pinnet/EasyPicoVGA/pico_vga_sd_aud_BOM_r2.xlsx

RPI-PVAS pico_vga_sd_aud BOM Rev2
17/079/2020
Reference designators | Quantity | Manufacturer Part Number (MPN) | Manufacturer | Description | Value
C1, C2 | 2 | GCM188R71C105KA64J | Murata | CAP CER 1UF 16V X7R 0603 | 1u
C9, C11 | 2 | GRM188R71A225KE15D | Murata | CAP CER 2.2UF 10V X7R 0603 | 2.2u
C3, C10, C16, C19 | 4 | GRM188R61A106KE69J | Murata | CAP CER 10UF 10V X5R 0603 | 10u
C4, C5, C6, C7, C8, C12, C13 | 7 | GRM155R71E104KE14J | Murata | CAP CER 0.1UF 25V X7R 0402 | 100n
C14, C15, C21 | 3 | GRM219R60J476ME44D | Murata | CAP CER 47UF 6.3V X5R 0805 | 47u
C17, C18 | 2 | GRM155R71H222KA01D | Murata | CAP CER 2200PF 50V X7R 0402 | 2.2n
D1 | 1 | MBR120VLSFT1G | ON Semiconductor | DIODE SCHOTTKY 20V 1A SOD123FL | MBR120VLSFT1G
J1, J2 | 2 | SJ-3523-SMT-TR | CUI Devices | CONN JACK STEREO 3.5MM SMD R/A | SJ-3523-SMT
J3 | 1 | 104031-0811 | Molex | CONN MICRO SD CARD PUSH-PULL R/A | 104031-0811
J4 | 1 | L77HDE15SD1CH4F | Amphenol ICC (Commercial Products) | CONN DSUB HD RCPT 15POS R/A SLDR | L77HDE15SD1CH4F
J5 | 1 | 10103594-0001LF | Amphenol ICC (FCI) | CONN RCPT USB2.0 MICRO B SMD R/A | 10103594-0001LF
J6 | 1 | TSW-102-23-T-S | Samtec Inc. | CONN HEADER VERT 2POS 2.54MM | TSW-102-23-T-S
J7 | 1 | 67997-208HLF | Amphenol ICC (FCI) | CONN HEADER VERT 8POS 2.54MM | 67997-208HLF
R1, R2 | 2 | RC0402FR-07220RL | Yageo | RES SMD 220 OHM 1% 1/16W 0402 | 220
R3, R4 | 2 | RC0402FR-07100RL | Yageo | RES SMD 100 OHM 1% 1/16W 0402 | 100
R5, R6 | 2 | RC0402FR-07470RP | Yageo | RES SMD 470 OHM 1% 1/16W 0402 | 470
R7, R8 | 2 | RC0402FR-071K8L | Yageo | RES SMD 1.8K OHM 1% 1/16W 0402 | 1.8K
R10, R11 | 2 | RC0402FR-0747RL | Yageo | RES SMD 47 OHM 1% 1/16W 0402 | 47
R20, R21, R22, R27, R32, R37 | 6 | RC0402FR-071KP | Yageo | RES SMD 1K OHM 1% 1/16W 0402 | 1k
R23, R24 | 2 | RC0402FR-0710KP | Yageo | RES SMD 10K OHM 1% 1/16W 0402 | 10k
R26, R31, R36 | 3 | RC0402FR-07499RL | Yageo | RES SMD 499 OHM 1% 1/16W 0402 | 499
R28, R33, R38 | 3 | RC0402FR-072KL | Yageo | RES SMD 2K OHM 1% 1/16W 0402 | 2k
R29, R34, R39 | 3 | RC0402FR-074K02L | Yageo | RES SMD 4.02K OHM 1% 1/16W 0402 | 4.02k
R30, R35, R40 | 3 | RC0402FR-078K06L | Yageo | RES SMD 8.06K OHM 1% 1/16W 0402 | 8.06k
SW1, SW2, SW3, SW4 | 4 | 434133025816 | Würth Elektronik | TACT SWITCH 4.2X3.2MM VERTICAL T | 434133025816
U1 | 1 | TLV70033DDCR | Texas Instruments | IC REG LINEAR 3.3V 200MA SOT23-5 | TLV70033DDCR
U3 | 1 | NC7WZ16P6X | ON Semiconductor | IC BUF NON-INVERT 5.5V SC70-6 | NC7WZ16P6X
U4 | 1 | PCM5101APWR | Texas Instruments | IC DAC 16/24/32BIT 384K 20TSSOP | PCM5101APWR
