pinnet/EasyPicoVGA/pico_vga_sd_aud.kicad_pcb

## KiCad design pico_vga_sd_aud.kicad_pcb (2021-02-02)

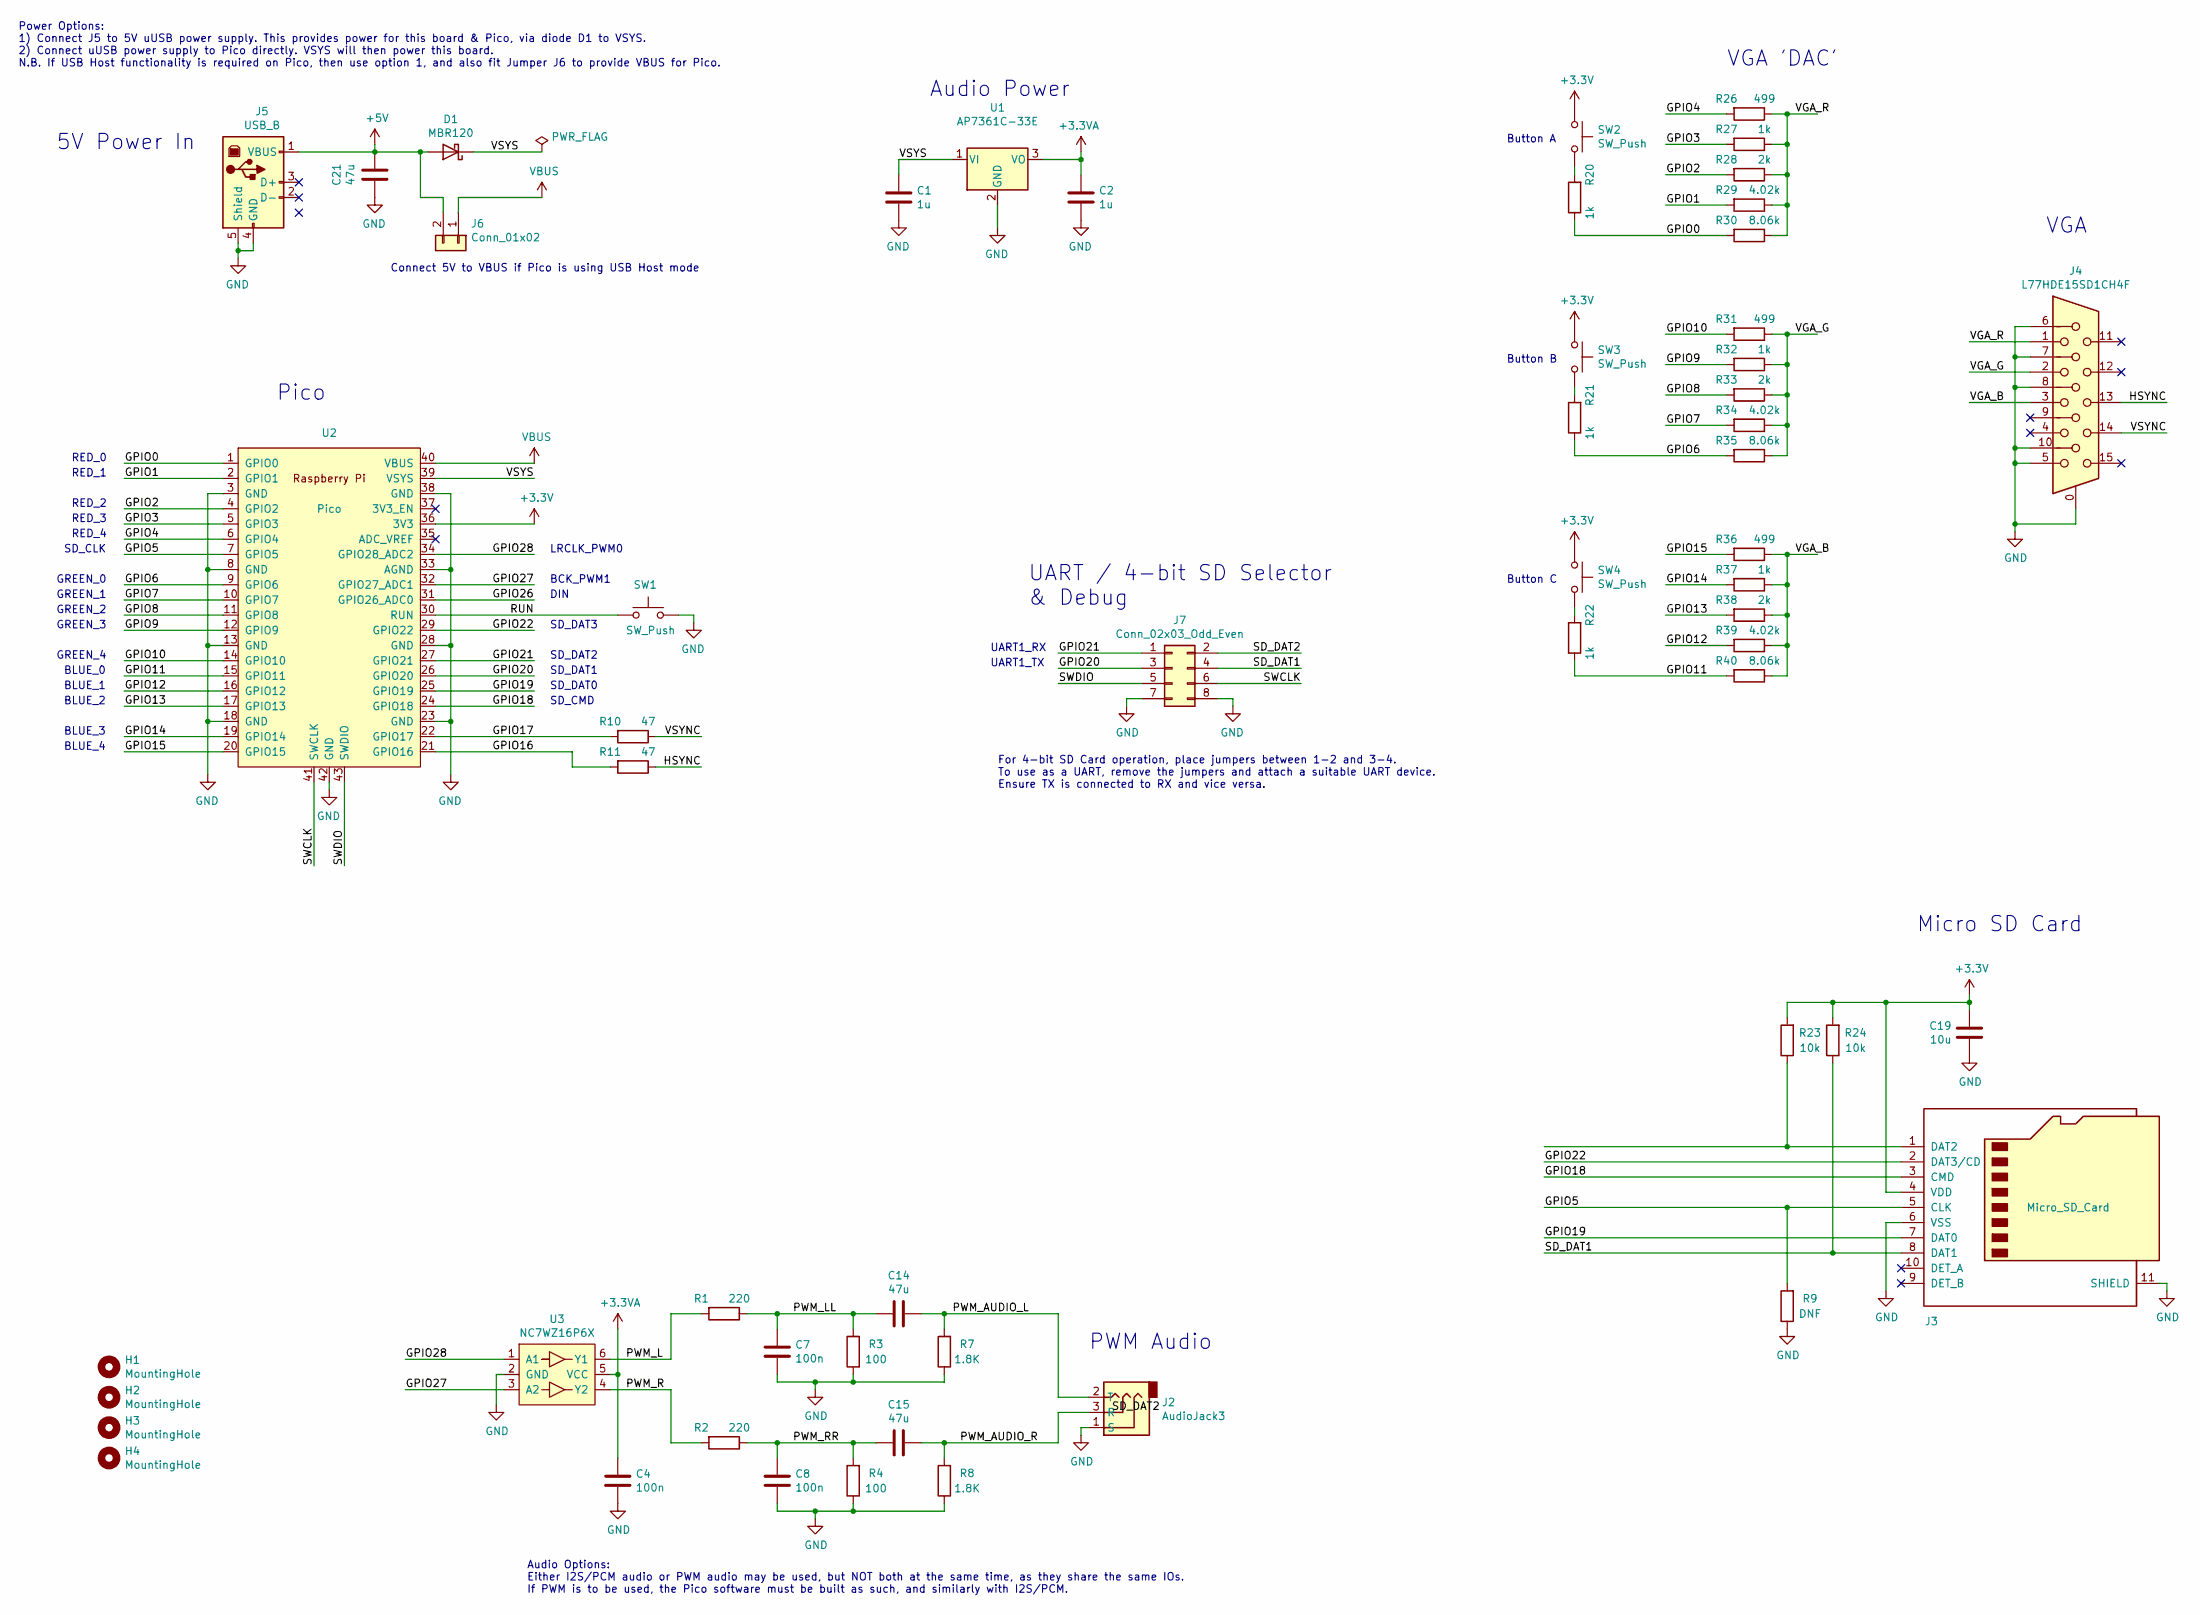
[picture p1: schematic pico_vga_sd_aud.sch, RPI-PVSA VGA, SD Card & Audio Demo Board for Pico]

Parts:
C1, C2: 1u; C_Disc_D4.7mm_W2.5mm_P5.00mm
C4, C7, C8: 100n; C_Disc_D4.7mm_W2.5mm_P5.00mm
C14, C15, C21: 47u; CP_Radial_D5.0mm_P2.50mm
C19: 10u; CP_Radial_D6.3mm_P2.50mm
D1: MBR120; D_A-405_P12.70mm_Horizontal
H1, H2, H3, H4: MountingHole; MountingHole_2.7mm_M2.5
J2: AudioJack3; CUI_SJ-3523-audio-jack
J3: Micro_SD_Card; microSD_HC_Molex_104031-0811
J4: L77HDE15SD1CH4F; DSUB-15-L77HDE15SD1CH4F
J5: USB_B; USB_B_Lumberg_2411_02_Horizontal
J6: Conn_01x02; PinHeader_1x02_P2.54mm_Vertical
J7: Conn_02x03_Odd_Even; PinHeader_2x04_P2.54mm_Vertical
R1, R2: 220; R_Axial_DIN0207_L6.3mm_D2.5mm_P15.24mm_Horizontal
R3, R4: 100; R_Axial_DIN0207_L6.3mm_D2.5mm_P15.24mm_Horizontal
R7, R8: 1.8K; R_Axial_DIN0207_L6.3mm_D2.5mm_P15.24mm_Horizontal
R9: DNF; R_Axial_DIN0207_L6.3mm_D2.5mm_P15.24mm_Horizontal
R10, R11: 47; R_Axial_DIN0207_L6.3mm_D2.5mm_P15.24mm_Horizontal
R20, R21, R22, R27, R32, R37: 1k; R_Axial_DIN0207_L6.3mm_D2.5mm_P15.24mm_Horizontal
R23, R24: 10k; R_Axial_DIN0207_L6.3mm_D2.5mm_P15.24mm_Horizontal
R26, R31, R36: 499; R_Axial_DIN0207_L6.3mm_D2.5mm_P15.24mm_Horizontal
R28, R33, R38: 2k; R_Axial_DIN0207_L6.3mm_D2.5mm_P15.24mm_Horizontal
R29, R34, R39: 4.02k; R_Axial_DIN0207_L6.3mm_D2.5mm_P15.24mm_Horizontal
R30, R35, R40: 8.06k; R_Axial_DIN0207_L6.3mm_D2.5mm_P15.24mm_Horizontal
SW1, SW2, SW3, SW4: SW_Push; SW_Tactile_SPST_Angled_PTS645Vx83-2LFS
U1: AP7361C-33E; TO-92_Inline
U2: Pico; RPi_Pico_SMD_TH
U3: NC7WZ16P6X; SOT-363_SC-70-6

Connections:
+3.3VA: C2.1, C4.1, U1.3 (VO), U3.5 (VCC)
+3V3: C19.1, J3.4 (VDD), R23.2, R24.2, SW2.1, SW3.1, SW4.1, U2.36 (3V3)
+5V: C21.1, D1.2 (A), J5.1 (VBUS), J6.2
/GPIO0: R20.1, R30.2, U2.1 (GPIO0)
/GPIO1: R29.2, U2.2 (GPIO1)
/GPIO2: R28.2, U2.4 (GPIO2)
/GPIO3: R27.2, U2.5 (GPIO3)
/GPIO4: R26.2, U2.6 (GPIO4)
/GPIO5: J3.5 (CLK), R9.2, U2.7 (GPIO5)
/GPIO6: R21.1, R35.2, U2.9 (GPIO6)
/GPIO7: R34.2, U2.10 (GPIO7)
/GPIO8: R33.2, U2.11 (GPIO8)
/GPIO9: R32.2, U2.12 (GPIO9)
/GPIO10: R31.2, U2.14 (GPIO10)
/GPIO11: R22.1, R40.2, U2.15 (GPIO11)
/GPIO12: R39.2, U2.16 (GPIO12)
/GPIO13: R38.2, U2.17 (GPIO13)
/GPIO14: R37.2, U2.19 (GPIO14)
/GPIO15: R36.2, U2.20 (GPIO15)
/GPIO16: R11.2, U2.21 (GPIO16)
/GPIO17: R10.2, U2.22 (GPIO17)
/GPIO18: J3.3 (CMD), U2.24 (GPIO18)
/GPIO19: J3.7 (DAT0), U2.25 (GPIO19)
/GPIO20: J7.3, U2.26 (GPIO20)
/GPIO21: J7.1, U2.27 (GPIO21)
/GPIO22: J3.2 (DAT3/CD), U2.29 (GPIO22)
/GPIO26: U2.31 (GPIO26_ADC0)
/GPIO27: U2.32 (GPIO27_ADC1), U3.3 (A2)
/GPIO28: U2.34 (GPIO28_ADC2), U3.1 (A1)
/HSYNC: J4.13, R11.1
/PWM_AUDIO_L: C14.1, J2.2 (T), R7.2
/PWM_AUDIO_R: C15.1, J2.3 (R), R8.2
/PWM_L: R1.2, U3.6 (Y1)
/PWM_LL: C7.1, C14.2, R1.1, R3.2
/PWM_R: R2.2, U3.4 (Y2)
/PWM_RR: C8.1, C15.2, R2.1, R4.2
/RUN: SW1.1, U2.30 (RUN)
/SD_DAT1: J3.8 (DAT1), J7.4, R24.1
/SD_DAT2: J7.2
/SWCLK: J7.6, U2.41 (SWCLK)
/SWDIO: J7.5, U2.43 (SWDIO)
/VGA_B: J4.3, R36.1, R37.1, R38.1, R39.1, R40.1
/VGA_G: J4.2, R31.1, R32.1, R33.1, R34.1, R35.1
/VGA_R: J4.1, R26.1, R27.1, R28.1, R29.1, R30.1
/VSYNC: J4.14, R10.1
/VSYS: C1.1, D1.1 (K), U1.1 (VI), U2.39 (VSYS)
GND: C1.2, C2.2, C4.2, C7.2, C8.2, C19.2, C21.2, J2.1 (S), J3.6 (VSS), J3.11 (SHIELD), J4.0, J4.5, J4.6, J4.7, J4.8, J4.10, J5.4 (GND), J5.5 (Shield), J7.7, J7.8, R3.1, R4.1, R7.1, R8.1, R9.1, SW1.2, U1.2 (GND), U2.3 (GND), U2.8 (GND), U2.13 (GND), U2.18 (GND), U2.23 (GND), U2.28 (GND), U2.33 (AGND), U2.38 (GND), U2.42 (GND), U3.2 (GND)
unnamed: J3.1 (DAT2), R23.1
unnamed: R20.2, SW2.2
unnamed: R21.2, SW3.2
unnamed: R22.2, SW4.2
VBUS: J6.1, U2.40 (VBUS)

Notes on the sheet:
Pico
Audio Power
PWM Audio
Micro SD Card
VGA
Connect 5V to VBUS if Pico is using USB Host mode
5V Power In
Power Options: 1) Connect J5 to 5V uUSB power supply. This provides power for this board & Pico, via diode D1 to VSYS. 2) Connect uUSB power supply to Pico directly. VSYS will then power this board. N.B. If USB Host functionality is required on Pico, then use option 1, and also fit Jumper J6 to pro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
VGA 'DAC'
Button A
Button B
Button C
SD_CLK
SD_CMD
SD_DAT0
SD_DAT1
SD_DAT2
SD_DAT3
DIN
BCK_PWM1
LRCLK_PWM0
RED_0
RED_1
RED_2
RED_3
RED_4
GREEN_0
GREEN_1
GREEN_2
GREEN_3
GREEN_4
BLUE_0
BLUE_1
BLUE_2
BLUE_3
BLUE_4
UART1_TX
UART1_RX
UART / 4-bit SD Selector & Debug
Audio Options: Either I2S/PCM audio or PWM audio may be used, but NOT both at the same time, as they share the same IOs. If PWM is to be used, the Pico software must be built as such, and similarly with I2S/PCM.
For 4-bit SD Card operation, place jumpers between 1-2 and 3-4. To use as a UART, remove the jumpers and attach a suitable UART device. Ensure TX is connected to RX and vice versa.

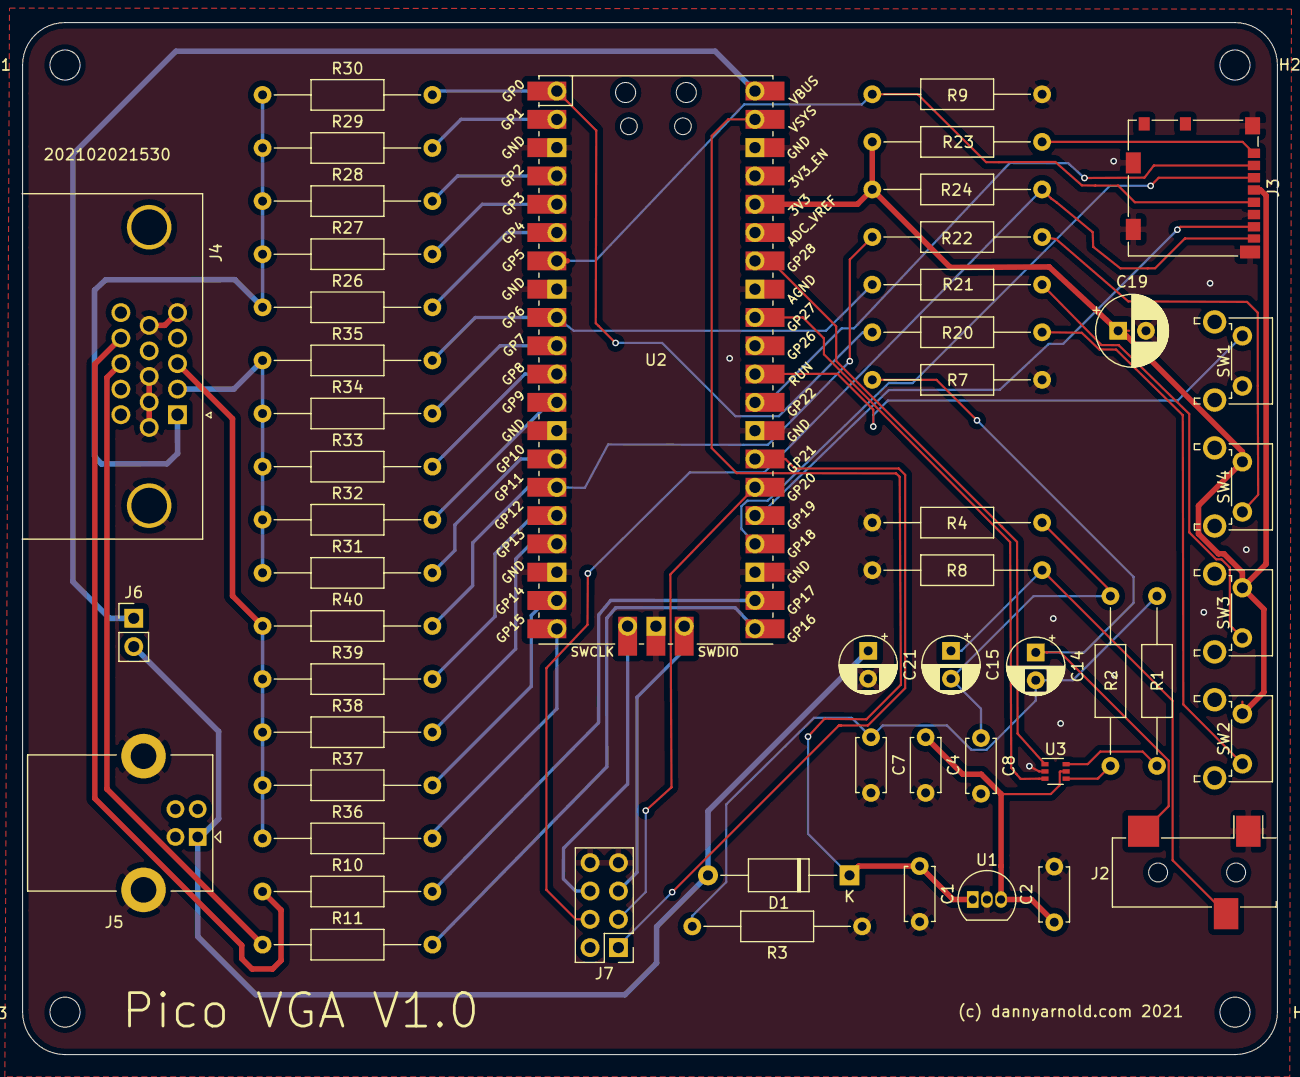
[picture p2: board pico_vga_sd_aud.kicad_pcb from above]

Board: 2 copper layers, 112.6 x 92.6 mm, 56 parts (0 on the bottom side), 50 nets.
